Dreamy-Z3r0/Clock-Project/README.md

# Clock project
Final product is a digital wallclock that makes use of an STM32 Blue Pill as main microcontroller and a generic ESP8266 as gateway for remote access.
