Dreamy-Z3r0/Clock-Project/Board-design-KiCAD/Clock/Clock.kicad_pcb

## KiCad design Board-design-KiCAD/Clock/Clock.kicad_pcb (2020-11-13)

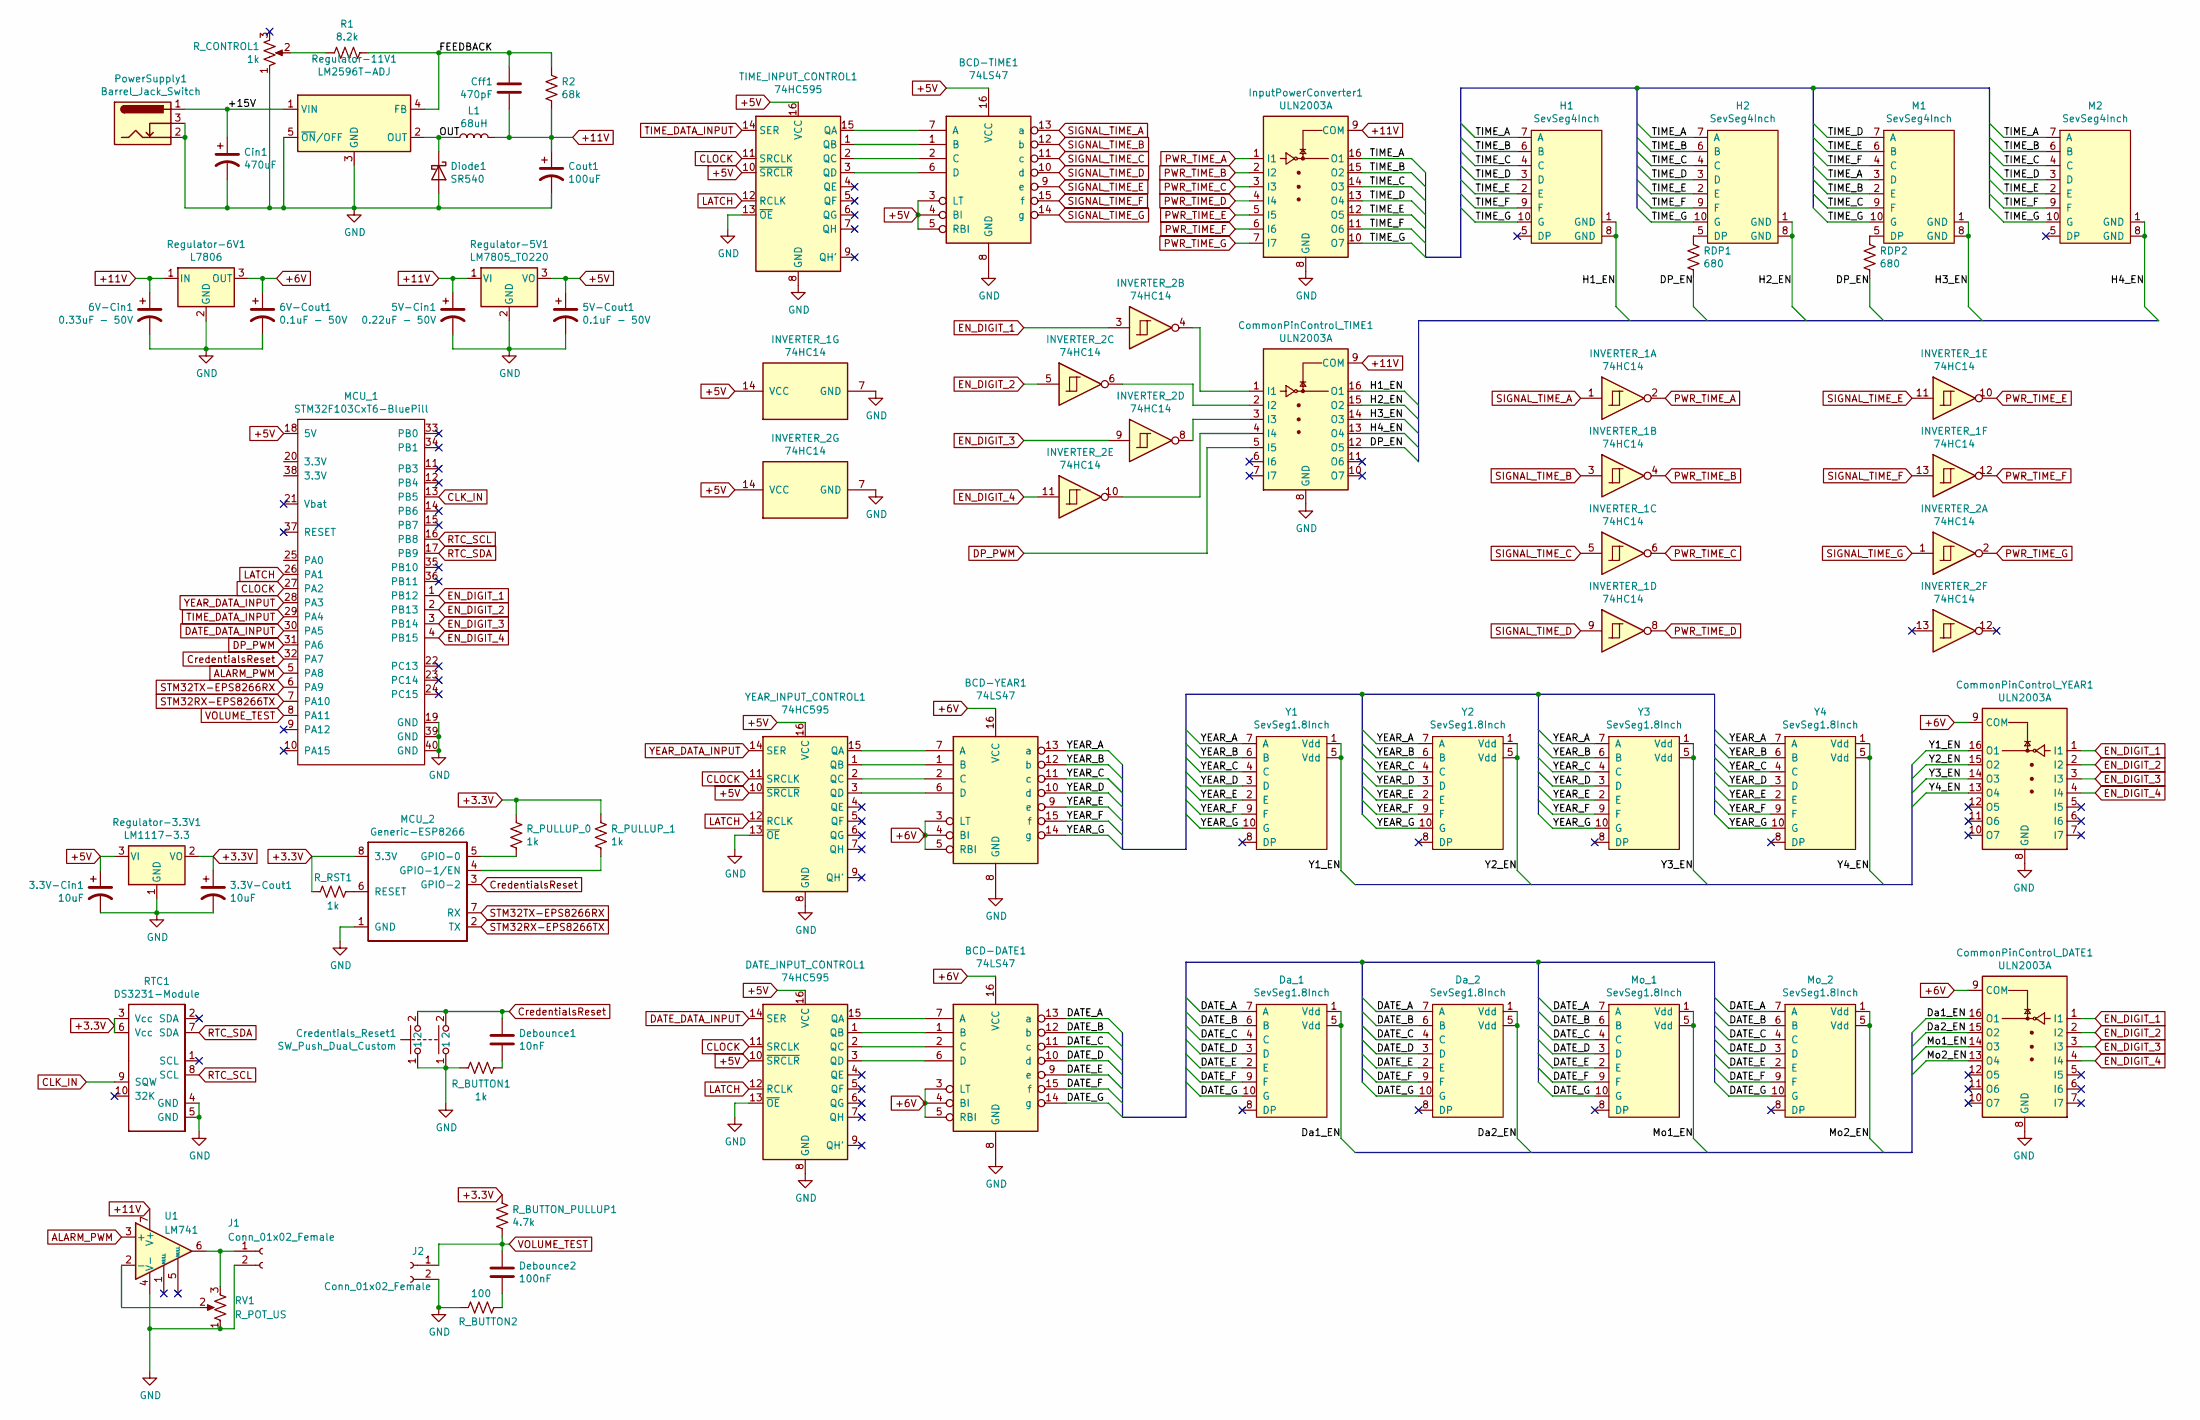
[picture p1: schematic Clock.sch]

Parts:
3.3V-Cin1, 3.3V-Cout1: 10uF; CP_Radial_D4.0mm_P2.00mm
5V-Cin1: 0.22uF - 50V; CP_Radial_D4.0mm_P2.00mm
5V-Cout1, 6V-Cout1: 0.1uF - 50V; CP_Radial_D5.0mm_P2.00mm
6V-Cin1: 0.33uF - 50V; CP_Radial_D4.0mm_P2.00mm
BCD-DATE1: 74LS47; DIP-16_W7.62mm_Socket_LongPads
BCD-TIME1: 74LS47; DIP-16_W7.62mm_Socket_LongPads
BCD-YEAR1: 74LS47; DIP-16_W7.62mm_Socket_LongPads
Cff1: 470pF; CP_Radial_H15.0mm_W14.0mm_T8.0mm_P8.5mm_Horizontal
Cin1: 470uF; CP_Radial_D10.0mm_P5.00mm
CommonPinControl_DATE1: ULN2003A; DIP-16_W7.62mm_Socket_LongPads
CommonPinControl_TIME1: ULN2003A; DIP-16_W7.62mm_Socket_LongPads
CommonPinControl_YEAR1: ULN2003A; DIP-16_W7.62mm_Socket_LongPads
Cout1: 100uF; CP_Radial_D8.0mm_P3.50mm
Credentials_Reset1: SW_Push_Dual_Custom; SW_PUSH-12mm_Wuerth-430476085716
DATE_INPUT_CONTROL1: 74HC595; DIP-16_W7.62mm_Socket_LongPads
Da_1, Da_2: SevSeg1.8Inch
Debounce1: 10nF; CP_Radial_H15.0mm_W14.0mm_T8.0mm_P8.5mm_Horizontal
Debounce2: 100nF; CP_Radial_H15.0mm_W14.0mm_T8.0mm_P8.5mm_Horizontal
Diode1: SR540; D_5600_9500Metric
H1, H2: SevSeg4Inch; SevSeg4inch
INVERTER_1, INVERTER_2: 74HC14; DIP-14_W7.62mm_Socket_LongPads
InputPowerConverter1: ULN2003A; DIP-16_W7.62mm_Socket_LongPads
J1, J2: Conn_01x02_Female; PinHeader_1x02_P2.54mm_Vertical
L1: 68uH; L_Radial_D10.0mm_P5.5mm
M1, M2: SevSeg4Inch; SevSeg4inch
MCU_1: STM32F103CxT6-BluePill
MCU_2: Generic-ESP8266
Mo_1, Mo_2: SevSeg1.8Inch
PowerSupply1: Barrel_Jack_Switch; BarrelJack_Horizontal
R1: 8.2k; R_Axial_DIN0207_L6.3mm_D2.5mm_P10.16mm_Horizontal
R2: 68k; R_Axial_DIN0207_L6.3mm_D2.5mm_P10.16mm_Horizontal
RDP1, RDP2: 680; R_Axial_DIN0207_L6.3mm_D2.5mm_P10.16mm_Horizontal
RTC1: DS3231-Module
RV1: R_POT_US; Potentiometer_Piher_T-16H_Single_Horizontal
R_BUTTON1: 1k; R_Axial_DIN0207_L6.3mm_D2.5mm_P10.16mm_Horizontal
R_BUTTON2: 100; R_Axial_DIN0207_L6.3mm_D2.5mm_P10.16mm_Horizontal
R_BUTTON_PULLUP1: 4.7k; R_Axial_DIN0207_L6.3mm_D2.5mm_P10.16mm_Horizontal
R_CONTROL1: 1k; Potentiometer_Vishay_T73YP_Vertical
R_PULLUP_0, R_PULLUP_1: 1k; R_Axial_DIN0207_L6.3mm_D2.5mm_P10.16mm_Horizontal
R_RST1: 1k; R_Axial_DIN0207_L6.3mm_D2.5mm_P10.16mm_Horizontal
Regulator-3.3V1: LM1117-3.3; TO-220-3_Horizontal_TabDown
Regulator-5V1: LM7805_TO220; TO-220-3_Horizontal_TabDown
Regulator-6V1: L7806; TO-220-3_Horizontal_TabDown
Regulator-11V1: LM2596T-ADJ; TO-220-5_Horizontal_TabUp
TIME_INPUT_CONTROL1: 74HC595; DIP-16_W7.62mm_Socket_LongPads
U1: LM741; DIP-8_W7.62mm_Socket_LongPads
Y1, Y2, Y3, Y4: SevSeg1.8Inch
YEAR_INPUT_CONTROL1: 74HC595; DIP-16_W7.62mm_Socket_LongPads

Connections:
+3.3V: 3.3V-Cout1.1, MCU_2.8 (3.3V), RTC1.3 (Vcc), RTC1.6 (Vcc), R_BUTTON_PULLUP1.1, R_PULLUP_0.1, R_PULLUP_1.1, R_RST1.2, Regulator-3.3V1.2 (VO)
+5V: 3.3V-Cin1.1, 5V-Cout1.1, BCD-TIME1.3 (LT), BCD-TIME1.4 (BI), BCD-TIME1.5 (RBI), BCD-TIME1.16 (VCC), DATE_INPUT_CONTROL1.10 (~SRCLR), DATE_INPUT_CONTROL1.16 (VCC), INVERTER_1.14 (VCC), INVERTER_2.14 (VCC), MCU_1.18 (5V), Regulator-3.3V1.3 (VI), Regulator-5V1.3 (VO), TIME_INPUT_CONTROL1.10 (~SRCLR), TIME_INPUT_CONTROL1.16 (VCC), YEAR_INPUT_CONTROL1.10 (~SRCLR), YEAR_INPUT_CONTROL1.16 (VCC)
+6V: 6V-Cout1.1, BCD-DATE1.3 (LT), BCD-DATE1.4 (BI), BCD-DATE1.5 (RBI), BCD-DATE1.16 (VCC), BCD-YEAR1.3 (LT), BCD-YEAR1.4 (BI), BCD-YEAR1.5 (RBI), BCD-YEAR1.16 (VCC), CommonPinControl_DATE1.9 (COM), CommonPinControl_YEAR1.9 (COM), Regulator-6V1.3 (OUT)
+11V: 5V-Cin1.1, 6V-Cin1.1, Cff1.2, CommonPinControl_TIME1.9 (COM), Cout1.1, InputPowerConverter1.9 (COM), L1.2, R2.2, Regulator-5V1.1 (VI), Regulator-6V1.1 (IN), U1.7 (V+)
/+15V: Cin1.1, PowerSupply1.1, Regulator-11V1.1 (VIN)
/DATE_A: BCD-DATE1.13 (a), Da_1.7 (A), Da_2.7 (A), Mo_1.7 (A), Mo_2.7 (A)
/DATE_B: BCD-DATE1.12 (b), Da_1.6 (B), Da_2.6 (B), Mo_1.6 (B), Mo_2.6 (B)
/DATE_C: BCD-DATE1.11 (c), Da_1.4 (C), Da_2.4 (C), Mo_1.4 (C), Mo_2.4 (C)
/DATE_D: BCD-DATE1.10 (d), Da_1.3 (D), Da_2.3 (D), Mo_1.3 (D), Mo_2.3 (D)
/DATE_E: BCD-DATE1.9 (e), Da_1.2 (E), Da_2.2 (E), Mo_1.2 (E), Mo_2.2 (E)
/DATE_F: BCD-DATE1.15 (f), Da_1.9 (F), Da_2.9 (F), Mo_1.9 (F), Mo_2.9 (F)
/DATE_G: BCD-DATE1.14 (g), Da_1.10 (G), Da_2.10 (G), Mo_1.10 (G), Mo_2.10 (G)
/DP_EN: CommonPinControl_TIME1.12 (O5), RDP1.2, RDP2.2
/Da1_EN: CommonPinControl_DATE1.16 (O1), Da_1.1 (Vdd), Da_1.5 (Vdd)
/Da2_EN: CommonPinControl_DATE1.15 (O2), Da_2.1 (Vdd), Da_2.5 (Vdd)
/FEEDBACK: Cff1.1, R1.2, R2.1, Regulator-11V1.4 (FB)
/H1_EN: CommonPinControl_TIME1.16 (O1), H1.1 (GND), H1.8 (GND)
/H2_EN: CommonPinControl_TIME1.15 (O2), H2.1 (GND), H2.8 (GND)
/H3_EN: CommonPinControl_TIME1.14 (O3), M1.1 (GND), M1.8 (GND)
/H4_EN: CommonPinControl_TIME1.13 (O4), M2.1 (GND), M2.8 (GND)
/Mo1_EN: CommonPinControl_DATE1.14 (O3), Mo_1.1 (Vdd), Mo_1.5 (Vdd)
/Mo2_EN: CommonPinControl_DATE1.13 (O4), Mo_2.1 (Vdd), Mo_2.5 (Vdd)
/OUT: Diode1.1 (K), L1.1, Regulator-11V1.2 (OUT)
/TIME_A: H1.7 (A), H2.7 (A), InputPowerConverter1.16 (O1), M1.3 (D), M2.7 (A)
/TIME_B: H1.6 (B), H2.6 (B), InputPowerConverter1.15 (O2), M1.2 (E), M2.6 (B)
/TIME_C: H1.4 (C), H2.4 (C), InputPowerConverter1.14 (O3), M1.9 (F), M2.4 (C)
/TIME_D: H1.3 (D), H2.3 (D), InputPowerConverter1.13 (O4), M1.7 (A), M2.3 (D)
/TIME_E: H1.2 (E), H2.2 (E), InputPowerConverter1.12 (O5), M1.6 (B), M2.2 (E)
/TIME_F: H1.9 (F), H2.9 (F), InputPowerConverter1.11 (O6), M1.4 (C), M2.9 (F)
/TIME_G: H1.10 (G), H2.10 (G), InputPowerConverter1.10 (O7), M1.10 (G), M2.10 (G)
/Y1_EN: CommonPinControl_YEAR1.16 (O1), Y1.1 (Vdd), Y1.5 (Vdd)
/Y2_EN: CommonPinControl_YEAR1.15 (O2), Y2.1 (Vdd), Y2.5 (Vdd)
/Y3_EN: CommonPinControl_YEAR1.14 (O3), Y3.1 (Vdd), Y3.5 (Vdd)
/Y4_EN: CommonPinControl_YEAR1.13 (O4), Y4.1 (Vdd), Y4.5 (Vdd)
/YEAR_A: BCD-YEAR1.13 (a), Y1.7 (A), Y2.7 (A), Y3.7 (A), Y4.7 (A)
/YEAR_B: BCD-YEAR1.12 (b), Y1.6 (B), Y2.6 (B), Y3.6 (B), Y4.6 (B)
/YEAR_C: BCD-YEAR1.11 (c), Y1.4 (C), Y2.4 (C), Y3.4 (C), Y4.4 (C)
/YEAR_D: BCD-YEAR1.10 (d), Y1.3 (D), Y2.3 (D), Y3.3 (D), Y4.3 (D)
/YEAR_E: BCD-YEAR1.9 (e), Y1.2 (E), Y2.2 (E), Y3.2 (E), Y4.2 (E)
/YEAR_F: BCD-YEAR1.15 (f), Y1.9 (F), Y2.9 (F), Y3.9 (F), Y4.9 (F)
/YEAR_G: BCD-YEAR1.14 (g), Y1.10 (G), Y2.10 (G), Y3.10 (G), Y4.10 (G)
ALARM_PWM: MCU_1.5 (PA8), U1.3 (+)
CLK_IN: MCU_1.13 (PB5), RTC1.9 (SQW)
CLOCK: DATE_INPUT_CONTROL1.11 (SRCLK), MCU_1.27 (PA2), TIME_INPUT_CONTROL1.11 (SRCLK), YEAR_INPUT_CONTROL1.11 (SRCLK)
CredentialsReset: Credentials_Reset1.2, Debounce1.1, MCU_1.32 (PA7), MCU_2.3 (GPIO-2)
DATE_DATA_INPUT: DATE_INPUT_CONTROL1.14 (SER), MCU_1.30 (PA5)
DP_PWM: CommonPinControl_TIME1.5 (I5), MCU_1.31 (PA6)
EN_DIGIT_1: CommonPinControl_DATE1.1 (I1), CommonPinControl_YEAR1.1 (I1), INVERTER_2.3, MCU_1.1 (PB12)
EN_DIGIT_2: CommonPinControl_DATE1.2 (I2), CommonPinControl_YEAR1.2 (I2), INVERTER_2.5, MCU_1.2 (PB13)
EN_DIGIT_3: CommonPinControl_DATE1.3 (I3), CommonPinControl_YEAR1.3 (I3), INVERTER_2.9, MCU_1.3 (PB14)
EN_DIGIT_4: CommonPinControl_DATE1.4 (I4), CommonPinControl_YEAR1.4 (I4), INVERTER_2.11, MCU_1.4 (PB15)
GND: 3.3V-Cin1.2, 3.3V-Cout1.2, 5V-Cin1.2, 5V-Cout1.2, 6V-Cin1.2, 6V-Cout1.2, BCD-DATE1.8 (GND), BCD-TIME1.8 (GND), BCD-YEAR1.8 (GND), Cin1.2, CommonPinControl_DATE1.8 (GND), CommonPinControl_TIME1.8 (GND), CommonPinControl_YEAR1.8 (GND), Cout1.2, Credentials_Reset1.1, DATE_INPUT_CONTROL1.8 (GND), DATE_INPUT_CONTROL1.13 (~OE), Diode1.2 (A), INVERTER_1.7 (GND), INVERTER_2.7 (GND), InputPowerConverter1.8 (GND), J1.2, J2.2, MCU_1.19 (GND), MCU_1.39 (GND), MCU_1.40 (GND), MCU_2.1 (GND), PowerSupply1.2, PowerSupply1.3, RTC1.4 (GND), RTC1.5 (GND), RV1.1, R_BUTTON1.1, R_BUTTON2.2, R_CONTROL1.1, Regulator-3.3V1.1 (GND), Regulator-5V1.2 (GND), Regulator-6V1.2 (GND), Regulator-11V1.3 (GND), Regulator-11V1.5 (~ON~/OFF), TIME_INPUT_CONTROL1.8 (GND), TIME_INPUT_CONTROL1.13 (~OE), U1.4 (V-), YEAR_INPUT_CONTROL1.8 (GND), YEAR_INPUT_CONTROL1.13 (~OE)
LATCH: DATE_INPUT_CONTROL1.12 (RCLK), MCU_1.26 (PA1), TIME_INPUT_CONTROL1.12 (RCLK), YEAR_INPUT_CONTROL1.12 (RCLK)
unnamed: BCD-DATE1.1 (B), DATE_INPUT_CONTROL1.1 (QB)
unnamed: BCD-DATE1.2 (C), DATE_INPUT_CONTROL1.2 (QC)
unnamed: BCD-DATE1.6 (D), DATE_INPUT_CONTROL1.3 (QD)
unnamed: BCD-DATE1.7 (A), DATE_INPUT_CONTROL1.15 (QA)
unnamed: BCD-TIME1.1 (B), TIME_INPUT_CONTROL1.1 (QB)
unnamed: BCD-TIME1.2 (C), TIME_INPUT_CONTROL1.2 (QC)
unnamed: BCD-TIME1.6 (D), TIME_INPUT_CONTROL1.3 (QD)
unnamed: BCD-TIME1.7 (A), TIME_INPUT_CONTROL1.15 (QA)
unnamed: BCD-YEAR1.1 (B), YEAR_INPUT_CONTROL1.1 (QB)
unnamed: BCD-YEAR1.2 (C), YEAR_INPUT_CONTROL1.2 (QC)
unnamed: BCD-YEAR1.6 (D), YEAR_INPUT_CONTROL1.3 (QD)
unnamed: BCD-YEAR1.7 (A), YEAR_INPUT_CONTROL1.15 (QA)
unnamed: CommonPinControl_TIME1.1 (I1), INVERTER_2.4
unnamed: CommonPinControl_TIME1.2 (I2), INVERTER_2.6
unnamed: CommonPinControl_TIME1.3 (I3), INVERTER_2.8
unnamed: CommonPinControl_TIME1.4 (I4), INVERTER_2.10
unnamed: Debounce1.2, R_BUTTON1.2
unnamed: Debounce2.2, R_BUTTON2.1
unnamed: H2.5 (DP), RDP1.1
unnamed: J1.1, RV1.3, U1.6
unnamed: M1.5 (DP), RDP2.1
unnamed: MCU_2.4 (GPIO-1/EN), R_PULLUP_1.2
unnamed: MCU_2.5 (GPIO-0), R_PULLUP_0.2
unnamed: MCU_2.6 (RESET), R_RST1.1
unnamed: R1.1, R_CONTROL1.2
unnamed: RV1.2, U1.2 (-)
PWR_TIME_A: INVERTER_1.2, InputPowerConverter1.1 (I1)
PWR_TIME_B: INVERTER_1.4, InputPowerConverter1.2 (I2)
PWR_TIME_C: INVERTER_1.6, InputPowerConverter1.3 (I3)
PWR_TIME_D: INVERTER_1.8, InputPowerConverter1.4 (I4)
PWR_TIME_E: INVERTER_1.10, InputPowerConverter1.5 (I5)
PWR_TIME_F: INVERTER_1.12, InputPowerConverter1.6 (I6)
PWR_TIME_G: INVERTER_2.2, InputPowerConverter1.7 (I7)
RTC_SCL: MCU_1.16 (PB8), RTC1.8 (SCL)
RTC_SDA: MCU_1.17 (PB9), RTC1.7 (SDA)
SIGNAL_TIME_A: BCD-TIME1.13 (a), INVERTER_1.1
SIGNAL_TIME_B: BCD-TIME1.12 (b), INVERTER_1.3
SIGNAL_TIME_C: BCD-TIME1.11 (c), INVERTER_1.5
SIGNAL_TIME_D: BCD-TIME1.10 (d), INVERTER_1.9
SIGNAL_TIME_E: BCD-TIME1.9 (e), INVERTER_1.11
SIGNAL_TIME_F: BCD-TIME1.15 (f), INVERTER_1.13
SIGNAL_TIME_G: BCD-TIME1.14 (g), INVERTER_2.1
STM32RX-EPS8266TX: MCU_1.7 (PA10), MCU_2.2 (TX)
STM32TX-EPS8266RX: MCU_1.6 (PA9), MCU_2.7 (RX)
TIME_DATA_INPUT: MCU_1.29 (PA4), TIME_INPUT_CONTROL1.14 (SER)
VOLUME_TEST: Debounce2.1, J2.1, MCU_1.8 (PA11), R_BUTTON_PULLUP1.2
YEAR_DATA_INPUT: MCU_1.28 (PA3), YEAR_INPUT_CONTROL1.14 (SER)

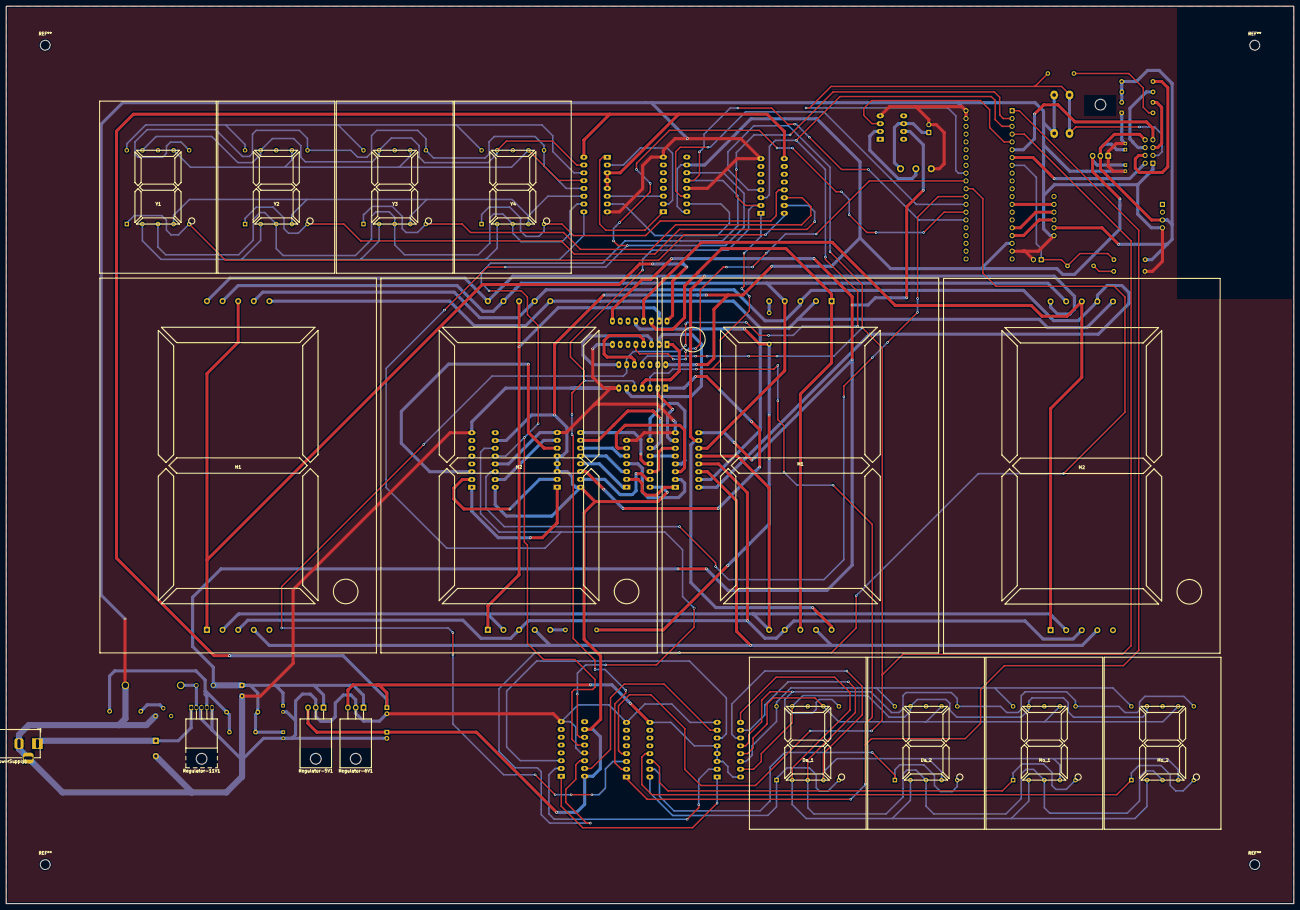
[picture p2: board Clock.kicad_pcb from above]

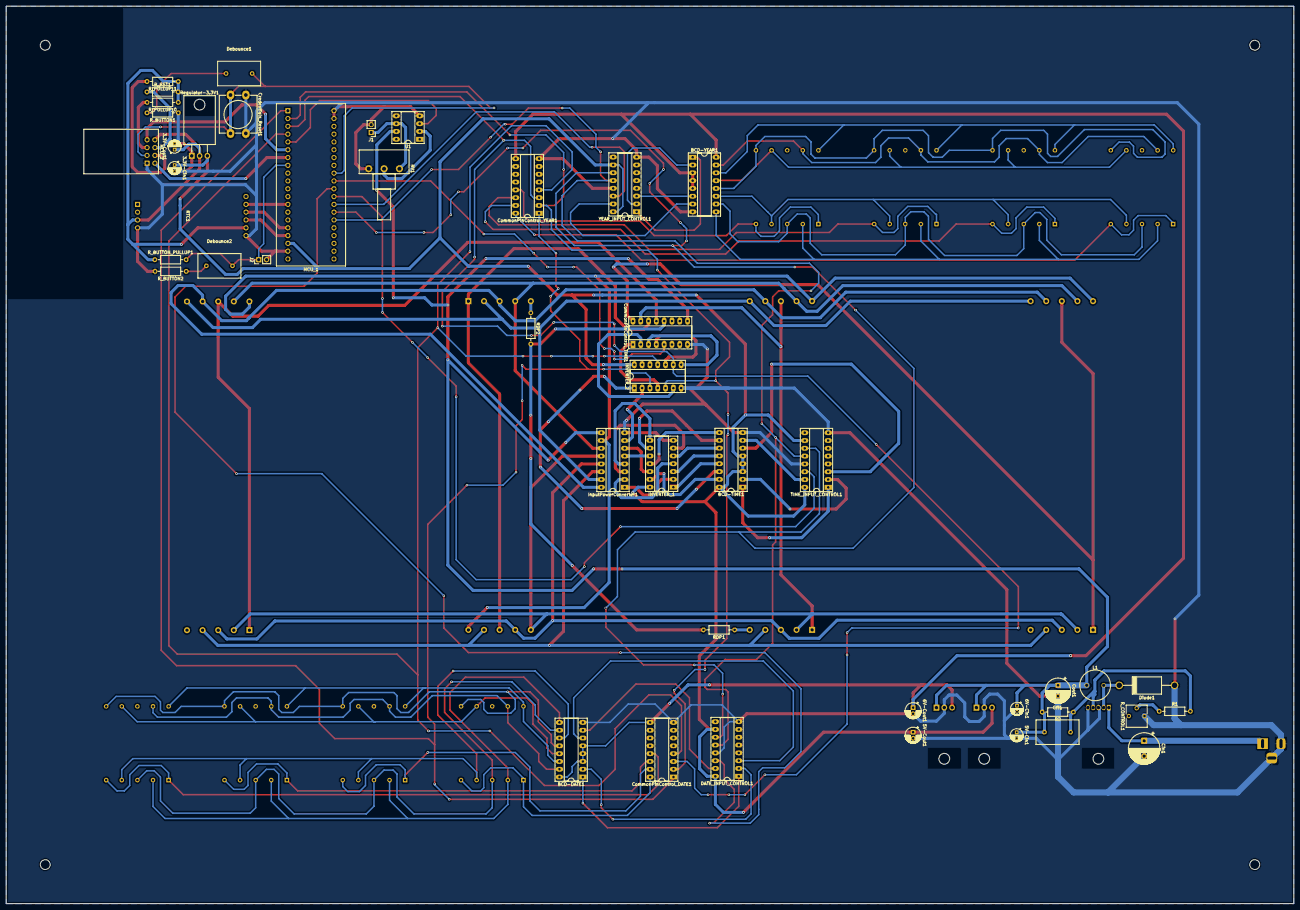
[picture p3: board Clock.kicad_pcb from below]

Board: 2 copper layers, 419.1 x 292.1 mm, 61 parts (45 on the bottom side), 100 nets.
