Dreamy-Z3r0/Clock-Project/Firmware/STM32-firmware/Core/Src/main.c

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
/* Includes ------------------------------------------------------------------*/
#include "main.h"

I2C_HandleTypeDef hi2c1;
DMA_HandleTypeDef hdma_i2c1_rx;
DMA_HandleTypeDef hdma_i2c1_tx;

TIM_HandleTypeDef htim2;
TIM_HandleTypeDef htim3;

UART_HandleTypeDef huart1;
DMA_HandleTypeDef hdma_usart1_rx;
DMA_HandleTypeDef hdma_usart1_tx;

/* USER CODE BEGIN PV */
	// DS3231 I2C Address
		uint8_t DS3231_ADDRESS = 0x68 << 1;

	/* I2C availability flag */
		_Bool I2C_available = 1;

	// Time data to write to DS3231
		uint8_t BCD_data_time[3];
		_Bool newTime = 0;

	// Date data to write to DS3231
		uint8_t BCD_data_date[7];
		_Bool newDate = 0;
		uint8_t BCD_data[7];

	/* I2C read request flag <- Pull time and date data from DS3231 */
		_Bool READ_NOW = 0;

	// Clock and Calendar data read from DS3231
		uint8_t BCD_readData[7];
	// Storage for time data to handle alarms
		uint8_t DEC_readData[2];

	/* Storage space for display digits */
		uint8_t dataOutput[3][4] =
		{
				{2, 0, 0, 0},		// YEAR
				{0, 0, 0, 0},		// TIME
				{0, 1, 0, 1}		// DATE
		};

	// Display digit handler
		uint8_t digitIndex = 0;

	// Alarm handler
		_Bool alarmON = 0;

	/* UART Busy Flag */
		_Bool UART_available = 1;

	/* UART1 transmit/receive command */
		uint8_t RECEIVED_MESSAGE = 0x00;

	/* Storage for data from UART1 */
		uint8_t RX_BUF[5];					// Received data
		uint8_t UART1_TRANSMIT_MESSAGE;		// Data to transmit

	/* UART data for transmission flags */
		_Bool Feedback_Message = 0;		// Availability of feedback message for ESP8266

	/* Alarm handlers */
		_Bool VOLUME_TEST = 0; 		// Testing buzzer melody flag
		_Bool BUZZER_ON = 0;		// Buzzer state flag

		_Bool REPEATED = 0;			// Flag for alarm melody to repeat only once

		uint8_t TIMER_INDEX = 0;			// Melody time frame index
		uint8_t TIMER_PRELOAD_SIZE = 0;		// Number of time frames for a melody

		uint16_t COUNTER_PERIOD = 65535;	// Value to update timer output compare register dynamically

		uint16_t TIMER_PRELOAD[] = {		// Buzzer melody preload values for timer
				10000, 819, 1168, 1104,
				1435, 1175, 3232, 1336,
				3234, 1300, 3317, 1035,
				1091, 985, 1124, 1106
		};

	/* Input pulses handlers */
		uint8_t EXTI_INTERRUPT_COUNTER = 0;		// Counter for 1-Hz input, recognising 5-s interval for time update cycle
		uint8_t ESP8266_RESET_COUNTER = 0;		// Counter taking 1-Hz input clock source for 5-s idle period

		// Storing reset state of ESP8266 to initiate idle period eliminating non-data UART transmission
		_Bool ESP8266_RESET_FLAG = 0;
/* USER CODE END PV */

void SystemClock_Config(void);
static void MX_GPIO_Init(void);
static void MX_DMA_Init(void);
static void MX_USART1_UART_Init(void);
static void MX_I2C1_Init(void);
static void MX_TIM2_Init(void);
static void MX_TIM3_Init(void);
/* USER CODE BEGIN PFP */
uint8_t dec2bcd(uint8_t bin_input);
uint8_t bcd2dec(uint8_t bcd_input);

void displayDataUpdate(uint8_t digitToUpdate);
void singleDigitUpdate(void);

void DATA_EXTRACTION(void);
void clockAlarm(void);
/* USER CODE END PFP */

/**
  * @brief  The application entry point.
  * @retval int
  */
int main(void)
{
  /* MCU Configuration--------------------------------------------------------*/

  /* Reset of all peripherals, Initializes the Flash interface and the Systick. */
  HAL_Init();

  /* Configure the system clock */
  SystemClock_Config();

  /* Initialize all configured peripherals */
  MX_GPIO_Init();
  MX_DMA_Init();
  MX_USART1_UART_Init();
  MX_I2C1_Init();
  MX_TIM2_Init();
  MX_TIM3_Init();
  /* USER CODE BEGIN 2 */
  HAL_GPIO_WritePin(ALARM_PWM_GPIO_Port, ALARM_PWM_Pin, RESET);
  HAL_GPIO_WritePin(BUILTIN_LED_GPIO_Port, BUILTIN_LED_Pin, SET);
  TIMER_PRELOAD_SIZE = sizeof(TIMER_PRELOAD) / sizeof(TIMER_PRELOAD[0]);

  // Initiate SQW at 1Hz on DS3231
  uint8_t SQW_INIT_COMMAND = 0x00;
  HAL_I2C_Mem_Write(&hi2c1, DS3231_ADDRESS, 0x0E, 1, &SQW_INIT_COMMAND, 1, 500);

  // Turn off display digits
  HAL_GPIO_WritePin(EN_DIGIT_1_GPIO_Port, EN_DIGIT_1_Pin, RESET);
  HAL_GPIO_WritePin(EN_DIGIT_2_GPIO_Port, EN_DIGIT_2_Pin, RESET);
  HAL_GPIO_WritePin(EN_DIGIT_3_GPIO_Port, EN_DIGIT_3_Pin, RESET);
  HAL_GPIO_WritePin(EN_DIGIT_4_GPIO_Port, EN_DIGIT_4_Pin, RESET);

  // Enable multiplexing clock
  HAL_TIM_OC_Start_IT(&htim2, TIM_CHANNEL_1);

  // Enable UART1 to listen to data/requests from ESP8266, delay to neglect any boot message from ESP8266
  HAL_Delay(5000);
  HAL_UART_Receive_DMA(&huart1, RX_BUF, 5);
  /* USER CODE END 2 */

  /* Infinite loop */
  /* USER CODE BEGIN WHILE */
  while (1)
  {
    /* USER CODE END WHILE */

    /* USER CODE BEGIN 3 */
	  if (I2C_available)
	  {
		  if (newTime)
		  {
			  I2C_available = 0;
			  newTime = 0;
			  HAL_I2C_Mem_Write_DMA(&hi2c1, DS3231_ADDRESS, 0x00, 1, BCD_data_time, 3);
			  alarmON = 0;
		  }
		  else if (newDate)
		  {
			  I2C_available = 0;
			  newDate = 0;
			  HAL_I2C_Mem_Write_DMA(&hi2c1, DS3231_ADDRESS, 0x03, 1, BCD_data_date, 4);
		  }
		  else if (READ_NOW)
		  {
			  I2C_available = 0;
			  READ_NOW = 0;
			  HAL_I2C_Mem_Read_DMA(&hi2c1, DS3231_ADDRESS, 0x00, 1, BCD_readData, 7);
		  }
	  }

	  if (UART_available)
	  {
		  if (Feedback_Message)
		  {
			  UART_available = 0;
			  Feedback_Message = 0;
			  HAL_UART_Transmit_DMA(&huart1, &UART1_TRANSMIT_MESSAGE, 1);
		  }
		  else
		  {
			  UART_available = 0;
			  HAL_UART_Receive_DMA(&huart1, RX_BUF, 5);			// Continue listening to data/requests from ESP8266
		  }
	  }

	  if (VOLUME_TEST ^ BUZZER_ON)
	  {
		  if (VOLUME_TEST)
		  {
			  BUZZER_ON = 1;

			  TIMER_INDEX = 0;
			  COUNTER_PERIOD = TIMER_PRELOAD[TIMER_INDEX];

			  MX_TIM3_Init();
			  HAL_TIM_OC_Start_IT(&htim3, TIM_CHANNEL_1);

			  HAL_GPIO_WritePin(ALARM_PWM_GPIO_Port, ALARM_PWM_Pin, RESET);
			  HAL_GPIO_WritePin(BUILTIN_LED_GPIO_Port, BUILTIN_LED_Pin, SET);
		  }
		  else
		  {
			  HAL_GPIO_WritePin(ALARM_PWM_GPIO_Port, ALARM_PWM_Pin, RESET);
			  HAL_GPIO_WritePin(BUILTIN_LED_GPIO_Port, BUILTIN_LED_Pin, SET);

			  HAL_TIM_OC_Stop_IT(&htim3, TIM_CHANNEL_1);
		  }
	  }
	  else if (alarmON & (255 == TIMER_INDEX))
	  {
		  TIMER_INDEX = 0;
		  COUNTER_PERIOD = TIMER_PRELOAD[TIMER_INDEX];

		  MX_TIM3_Init();
		  HAL_TIM_OC_Start_IT(&htim3, TIM_CHANNEL_1);

		  HAL_GPIO_WritePin(ALARM_PWM_GPIO_Port, ALARM_PWM_Pin, RESET);
		  HAL_GPIO_WritePin(BUILTIN_LED_GPIO_Port, BUILTIN_LED_Pin, SET);
	  }
  }
  /* USER CODE END 3 */
}

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
/* USER CODE BEGIN 4 */
void displayDataUpdate(uint8_t digitToUpdate)
{
	HAL_GPIO_WritePin (LATCH_GPIO_Port, LATCH_Pin, RESET);	// Pull LATCH pin LOW to push data to shift registers

	for (uint8_t index = 0; index <= 3; index++)
	{
		HAL_GPIO_WritePin(CLOCK_GPIO_Port, CLOCK_Pin, RESET);	// Prepares for next bit input by pulling CLOCK pin LOW
		HAL_GPIO_WritePin( YEAR_GPIO_Port,  YEAR_Pin, (dataOutput[0][digitToUpdate] & (1 << index)) >> index);
		HAL_GPIO_WritePin( TIME_GPIO_Port,  TIME_Pin, (dataOutput[1][digitToUpdate] & (1 << index)) >> index);
		HAL_GPIO_WritePin( DATE_GPIO_Port,  DATE_Pin, (dataOutput[2][digitToUpdate] & (1 << index)) >> index);
		HAL_GPIO_WritePin(CLOCK_GPIO_Port, CLOCK_Pin, SET);		// Shifts next input bit by pulling CLOCK pin HIGH
	}
}

void singleDigitUpdate(void)
{
	// Pull LATCH pin HIGH to update output on shift registers
	HAL_GPIO_WritePin(LATCH_GPIO_Port, LATCH_Pin, SET);

	// Turn on updated digits
	if (0 == digitIndex)
	{
		HAL_GPIO_WritePin(EN_DIGIT_4_GPIO_Port, EN_DIGIT_4_Pin, RESET);
		HAL_GPIO_WritePin(EN_DIGIT_1_GPIO_Port, EN_DIGIT_1_Pin, SET);
	}
	else if (1 == digitIndex)
	{
		HAL_GPIO_WritePin(EN_DIGIT_1_GPIO_Port, EN_DIGIT_1_Pin, RESET);
		HAL_GPIO_WritePin(EN_DIGIT_2_GPIO_Port, EN_DIGIT_2_Pin, SET);
	}
	else if (2 == digitIndex)
	{
		HAL_GPIO_WritePin(EN_DIGIT_2_GPIO_Port, EN_DIGIT_2_Pin, RESET);
		HAL_GPIO_WritePin(EN_DIGIT_3_GPIO_Port, EN_DIGIT_3_Pin, SET);
	}
	else if (3 == digitIndex)
	{
		HAL_GPIO_WritePin(EN_DIGIT_3_GPIO_Port, EN_DIGIT_3_Pin, RESET);
		HAL_GPIO_WritePin(EN_DIGIT_4_GPIO_Port, EN_DIGIT_4_Pin, SET);
	}

	// Prepare multiplexing on the next digits
	digitIndex += 1;
	if (4 == digitIndex)
		digitIndex = 0;
}

uint8_t dec2bcd(uint8_t bin_input)		// Converts number from decimal format to BCD format
{
	return (((bin_input / 10) << 4) | (bin_input % 10));
}

uint8_t bcd2dec(uint8_t bcd_input)		// Converts number from BCD format to decimal format
{
	return (((bcd_input & 0xF0) >> 4) * 10) + (bcd_input & 0x0F);
}

void DATA_EXTRACTION(void)		// Update dataOutput[][] every time data is pulled from DS3231
{
	// Extract year digits
	dataOutput[0][2] = (BCD_readData[6] & 0xF0) >> 4;	// Tens digit from DS3231 year data in BCD format
	dataOutput[0][3] =  BCD_readData[6] & 0x0F;			// Unit digit from DS3231 year data in BCD format

	// Extract hour digits
	dataOutput[1][0] = (BCD_readData[2] & 0x30) >> 4;	// Tens digit from DS3231 hour data in BCD format
	dataOutput[1][1] =  BCD_readData[2] & 0x0F;			// Unit digit from DS3231 hour data in BCD format

	// Extract minute digits
	dataOutput[1][2] = (BCD_readData[1] & 0xF0) >> 4;	// Tens digit from DS3231 minute data in BCD format
	dataOutput[1][3] =  BCD_readData[1] & 0x0F;			// Unit digit from DS3231 minute data in BCD format

	// Extract date digits
	dataOutput[2][0] = (BCD_readData[4] & 0xF0) >> 4;	// Tens digit from DS3231 date data in BCD format
	dataOutput[2][1] =  BCD_readData[4] & 0x0F;			// Unit digit from DS3231 date data in BCD format

	// Extract month digits
	dataOutput[2][2] = (BCD_readData[5] & 0x10) >> 4;	// Tens digit from DS3231 month data in BCD format
	dataOutput[2][3] =  BCD_readData[5] & 0x0F;			// Unit digit from DS3231 month data in BCD format

	// Update alarm checking storage
	DEC_readData[0] = bcd2dec(BCD_readData[2]);		// Hour value
	DEC_readData[1] = bcd2dec(BCD_readData[1]);		// Minute value
}

void clockAlarm(void)	// Handler of alarm flag and alarm request
{
	// Check if current time is exactly 7:00, 11:00, 13:00, or 17:00 (neglecting seconds)
	_Bool AlarmCondition = 1;
	AlarmCondition &= (DEC_readData[1] == 0);
	AlarmCondition &= (((BCD_readData[2] & 0x0F) == 7) | (DEC_readData[0] == 11) | (DEC_readData[0] == 13));

	if (AlarmCondition) 	// Current time is 7:00, 11:00, 13:00, or 17:00
	{
		if ((!alarmON) & (!VOLUME_TEST))	// Alarm is off and volume test condition is FALSE
		{
			// Enable alarm
			alarmON = 1;
			TIMER_INDEX = 255;
			REPEATED = 0;
		}
	}
	else if (alarmON)		// Current time has passed alarm point
	{
		alarmON = 0;	// Disable alarm flag
	}
}

void HAL_TIM_OC_DelayElapsedCallback(TIM_HandleTypeDef * htim)
{
	if (htim == &htim2)			// Multiplexing with ~5ms interval
	{
		displayDataUpdate(digitIndex);	// Push data for the next digit to be updated
		singleDigitUpdate();			// Enable the updated digit
	}
	else if (htim == &htim3)
	{
		TIMER_INDEX += 1;
		if (TIMER_PRELOAD_SIZE > TIMER_INDEX)
		{
			HAL_GPIO_TogglePin(ALARM_PWM_GPIO_Port, ALARM_PWM_Pin);
			HAL_GPIO_TogglePin(BUILTIN_LED_GPIO_Port, BUILTIN_LED_Pin);
			COUNTER_PERIOD = TIMER_PRELOAD[TIMER_INDEX];

			MX_TIM3_Init();
			HAL_TIM_OC_Start_IT(&htim3, TIM_CHANNEL_1);
		}
		else if (VOLUME_TEST)
		{
			HAL_GPIO_WritePin(ALARM_PWM_GPIO_Port, ALARM_PWM_Pin, RESET);
			HAL_GPIO_WritePin(BUILTIN_LED_GPIO_Port, BUILTIN_LED_Pin, SET);

			TIMER_INDEX = 0;
			COUNTER_PERIOD = TIMER_PRELOAD[TIMER_INDEX];

			MX_TIM3_Init();
			HAL_TIM_OC_Start_IT(&htim3, TIM_CHANNEL_1);
		}
		else if (!REPEATED)
		{
			HAL_GPIO_WritePin(ALARM_PWM_GPIO_Port, ALARM_PWM_Pin, RESET);
			HAL_GPIO_WritePin(BUILTIN_LED_GPIO_Port, BUILTIN_LED_Pin, SET);

			REPEATED = 1;
			TIMER_INDEX = 0;
			COUNTER_PERIOD = TIMER_PRELOAD[TIMER_INDEX];

			MX_TIM3_Init();
			HAL_TIM_OC_Start_IT(&htim3, TIM_CHANNEL_1);
		}
		else
		{
			HAL_GPIO_WritePin(ALARM_PWM_GPIO_Port, ALARM_PWM_Pin, RESET);
			HAL_GPIO_WritePin(BUILTIN_LED_GPIO_Port, BUILTIN_LED_Pin, SET);
			HAL_TIM_OC_Stop_IT(&htim3, TIM_CHANNEL_1);
		}
	}
}

void HAL_GPIO_EXTI_Callback(uint16_t GPIO_Pin)
{
	if (GPIO_Pin == CLK_IN_Pin)
	{
		HAL_GPIO_TogglePin(DP_OUT_GPIO_Port, DP_OUT_Pin);
		EXTI_INTERRUPT_COUNTER += 1;

		if (5 == EXTI_INTERRUPT_COUNTER)	// Pull clock and calendar data from DS3231 every 5s
		{
			EXTI_INTERRUPT_COUNTER = 0;		// Reset counter
			READ_NOW = 1;					// Enable read flag
		}

		if (ESP8266_RESET_FLAG)
		{
			ESP8266_RESET_COUNTER += 1;

			if (5 == ESP8266_RESET_COUNTER)
			{
				ESP8266_RESET_FLAG = 0;
				HAL_UART_DMAResume(&huart1);
			}
		}
	}
	else if (GPIO_Pin == ESP8266_RESET_Pin)
	{
		HAL_UART_DMAPause(&huart1);
		ESP8266_RESET_COUNTER = 0;
		ESP8266_RESET_FLAG = 1;
	}
	else if (GPIO_Pin == VOLUME_TEST_Pin)
	{
		if (VOLUME_TEST)
		{
			VOLUME_TEST = 0;
		}
		else
		{
			VOLUME_TEST = 1;
			BUZZER_ON = 0;
		}
	}
	else
	{
		__NOP();
	}
}

void HAL_I2C_MemRxCpltCallback (I2C_HandleTypeDef * hi2c)
{
	DATA_EXTRACTION();
	clockAlarm();

	I2C_available = 1;
}

void HAL_I2C_MemTxCpltCallback (I2C_HandleTypeDef * hi2c)
{
	I2C_available = 1;
}

void HAL_UART_TxCpltCallback (UART_HandleTypeDef * huart)
{
	UART_available = 1;
}

void HAL_UART_RxCpltCallback (UART_HandleTypeDef * huart)
{
	UART_available = 1;

	if (huart == &huart1)
	{
		_Bool dataCheck = 1;	// Validates received data from ESP8266
		if ('T' == RX_BUF[0])	// Data received from ESP8266 is time data
		{
			dataCheck &= ((0 <= RX_BUF[1]) & (RX_BUF[1] <= 23));	// RX_BUF[1] should be hour value ranging from 0 to 23
			dataCheck &= ((0 <= RX_BUF[2]) & (RX_BUF[2] <= 59));	// RX_BUF[2] should be minute value ranging from 0 to 59

			if (dataCheck)	// Data is valid
			{
				newTime = 10;	// Force disabling availability flag to update new data
				UART1_TRANSMIT_MESSAGE = 'O';	// Feedback message is 'ACKNOWLEDGED'

				BCD_data_time[0] = 55;					// Second = 10
				BCD_data_time[1] = dec2bcd(RX_BUF[2]);	// Get minute value in BCD format to update DS3231
				BCD_data_time[2] = dec2bcd(RX_BUF[1]);	// Get hour value in BCD format to update DS3231

				newTime = 1;	// New time data has been issued
			}
			else			// Data received is not valid
			{
				UART1_TRANSMIT_MESSAGE = 'r';	// Feedback message is a request for ESP8266 to re-send data
			}

		}
		else if ('D' == RX_BUF[0])	// Data received from ESP8266 is date data
		{
			dataCheck &= ((1 <= RX_BUF[1]) & (RX_BUF[1] <= 31));	// RX_BUF[1] should be date value ranging from 1 to 31
			dataCheck &= ((1 <= RX_BUF[2]) & (RX_BUF[2] <= 12));	// RX_BUF[2] should be month value ranging from 1 to 12

			uint16_t temp = (((uint16_t)RX_BUF[3]) << 8) | ((uint16_t)RX_BUF[4]);	// Acquire 16-bit year value
			dataCheck &= ((1980 <= temp) & (temp <= 2099));			// Year value should be from 1980 to 2099 (supported by DS3231)

			if (dataCheck)	// Data is valid
			{
				newDate = 0;	// Force disabling availability flag to update new data
				UART1_TRANSMIT_MESSAGE = 'O';	// Feedback message is 'ACKNOWLEDGED'

				BCD_data_date[1] = dec2bcd(RX_BUF[1]);		// Get date of month value in BCD format to update DS3231
				BCD_data_date[2] = dec2bcd(RX_BUF[2]);		// Get month value in BCD format to update DS3231
				BCD_data_date[3] = dec2bcd(temp - 2000);	// Get year value in BCD format to update DS3231 (Only years from 2000 to 2099 are valid)

				uint8_t DoW = (RX_BUF[1]+=RX_BUF[2]<3?temp--:temp-2,23*RX_BUF[2]/9+RX_BUF[1]+4+temp/4-temp/100+temp/400)%7;
				BCD_data_date[0] = DoW + 1;					// Day of week: 1 = Sunday, 2 = Monday, etc.

				newDate = 1;	// New date data has been issued
			}
			else			// Data received is not valid
			{
				UART1_TRANSMIT_MESSAGE = 'r';	// Feedback message is a request for ESP8266 to re-send data
			}
		}
		else if ('r' == RX_BUF[0])	// Unable to recognise what kind of data/request transmitted by ESP8266
		{
			__NOP();
		}
		else
		{
			UART1_TRANSMIT_MESSAGE = 'r';	// Feedback message is a request for ESP8266 to re-send data
		}

		// Enable transmitting feedback message to ESP8266
		Feedback_Message = 1;
	}
}

/* USER CODE END 4 */
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
