Dreamy-Z3r0/Clock-Project/Firmware/STM32-firmware/STM32-firmware.ioc

Mcu.UserName=STM32F103CBTx
PB14.GPIO_Label=EN_DIGIT_3
PA6.GPIO_Label=DP_OUT
PB13.GPIO_Label=EN_DIGIT_2
PB13.Signal=GPIO_Output
PB15.Signal=GPIO_Output
PD1-OSC_OUT.Signal=RCC_OSC_OUT
PB12.GPIO_Label=EN_DIGIT_1
PA8.Signal=GPIO_Output
PB9.Signal=I2C1_SDA
PA6.Signal=GPIO_Output
PA2.GPIO_Label=CLOCK
PA10.Signal=USART1_RX
PB5.GPIO_Label=CLK_IN
PA4.GPIO_Label=TIME
PA3.Signal=GPIO_Output
PC13-TAMPER-RTC.Signal=GPIO_Output
PA11.GPIO_Label=VOLUME_TEST
PD0-OSC_IN.Signal=RCC_OSC_IN
PA13.Signal=SYS_JTMS-SWDIO
PA8.GPIO_Label=ALARM_PWM
PA9.Signal=USART1_TX
PA1.Signal=GPIO_Output
PB14.Signal=GPIO_Output
PA5.Signal=GPIO_Output
PC13-TAMPER-RTC.GPIO_Label=BUILTIN_LED
PB15.GPIO_Label=EN_DIGIT_4
PA1.GPIO_Label=LATCH
PA2.Signal=GPIO_Output
PA4.Signal=GPIO_Output
PB5.Signal=GPXTI5
PA7.GPIO_Label=ESP8266_RESET
PA5.GPIO_Label=DATE
PA11.Signal=GPXTI11
PA14.Signal=SYS_JTCK-SWCLK
PB8.Signal=I2C1_SCL
PB12.Signal=GPIO_Output
PA3.GPIO_Label=YEAR
PA7.Signal=GPXTI7
