Dreamy-Z3r0/Clock-Project/(commit log)

2020-09-10 Rearrange repositories
    [Clock.kicad_pcb, Clock.sch]
2020-09-10 Rearrange some components on the schematics
    [Clock.sch]
2020-09-14 Create project for STM32 firmware and add some general settings
2020-09-16 Add some components
    [Clock.sch]
2020-09-16 Add power supply and 11-V regulator
    [Clock.sch]
2020-09-17 Build PCB part for external power supply
    [Clock.kicad_pcb, Clock.sch]
2020-09-17 Add some PCB routes
    [Clock.kicad_pcb, Clock.sch]
2020-09-18 Add new tracks
    [Clock.kicad_pcb, Clock.sch]
2020-09-19 Add some display wirings
    [Clock.kicad_pcb, Clock.sch]
2020-09-19 Finish display wirings
    [Clock.kicad_pcb]
2020-09-19 Rearrange some minor components
    [Clock.kicad_pcb]
2020-09-19 Create new symbol and footprint for STM32F103CxT6 Blue Pill
2020-09-19 Add Blue Pill to schematics
    [Clock.sch]
2020-09-19 Add Blue Pill footprint on PCB design and perform existing wirings
    [Clock.kicad_pcb, Clock.sch]
2020-09-19 Finish integrating WiFi and RTC
    [Clock.kicad_pcb, Clock.sch]
2020-09-20 Add I2C settings to STM32 firmware
2020-09-20 Update part(s): DS3231 RTC Module
    [Clock.kicad_pcb, Clock.sch]
2020-09-26 Add processing functions for date and time input from HTML; Add data transfer function via UART.
2020-09-27 Add credential reset button for ESP8266
    [Clock.kicad_pcb, Clock.sch]
2020-09-27 Discard STM32 firmware for rework
    [main.c, main.h]
2020-09-27 STM32 cleared
2020-09-27 Add credential reset, hardware setup needed
    [ESP8266-firmware.ino, STM32-firmware.ioc]
2020-09-28 Modify button circuit and build code for button management.
    [Clock.kicad_pcb, Clock.sch]
2020-09-28 Add DS3231 memory write
    [Clock.kicad_pcb, Clock.sch]
2020-09-29 Add timer functionalities
2020-09-30 Add functions handling UART3; Add some code comments.
2020-09-30 Rework on UART transfer
    [ESP8266-firmware.ino]
2020-10-01 Remove DMA for UART3 and UART1 TX
2020-10-02 New changes to overcome runtime errors
    [STM32-firmware.ioc, main.c]
2020-10-05 Fix some errors in calculations for PWM on channel 3
    [STM32-firmware.ioc, main.c]
2020-10-06 Use I2C on alternative pins. Code finished.
    [Clock.kicad_pcb, Clock.sch]
2020-10-07 Add some names
    [Clock.kicad_pcb, Clock.sch]
2020-10-09 Possible solution for audio amplifier
    [Clock.sch]
2020-10-16 Fix some existing errors
    [Clock.kicad_pcb]
2020-10-25 Rework on alarm function
    [Clock.kicad_pcb, Clock.sch]
2020-10-28 Finish up PCB design and fix some minor firmware issue
    [Clock.kicad_pcb, Clock.sch]
2020-10-29 Add mounting holes and generate gerber files
    [Clock-B_Cu.gbl, Clock-B_Mask.gbs, Clock-B_Paste.gbp, Clock-B_SilkS.gbo, Clock-Edge_Cuts.gm1, Clock-F_Cu.gtl, Clock-F_Mask.gts, Clock-F_Paste.gtp]
2020-11-13 Resolve problems raised from datasheets
    [Clock-B_Cu.gbl, Clock-B_Mask.gbs, Clock-B_Paste.gbp, Clock-B_SilkS.gbo, Clock-Edge_Cuts.gm1, Clock-F_Cu.gtl, Clock-F_Mask.gts, Clock-F_Paste.gtp]
2020-11-13 Place origin
    [Clock-B_Cu.gbl, Clock-B_Mask.gbs, Clock-B_Paste.gbp, Clock-B_SilkS.gbo, Clock-Edge_Cuts.gm1, Clock-F_Cu.gtl, Clock-F_Mask.gts, Clock-F_Paste.gtp]
2020-11-13 Export gerber files to meet manufacturer's requirements
    [Clock-B_Cu.gbl, Clock-B_Mask.gbs, Clock-B_Paste.gbp, Clock-B_SilkS.gbo, Clock-Edge_Cuts.gm1, Clock-F_Cu.gtl, Clock-F_Mask.gts, Clock-F_Paste.gtp]
